williamdelsea/Protogen-Flex-Glove/.repo/images/paperSchematic.jpg

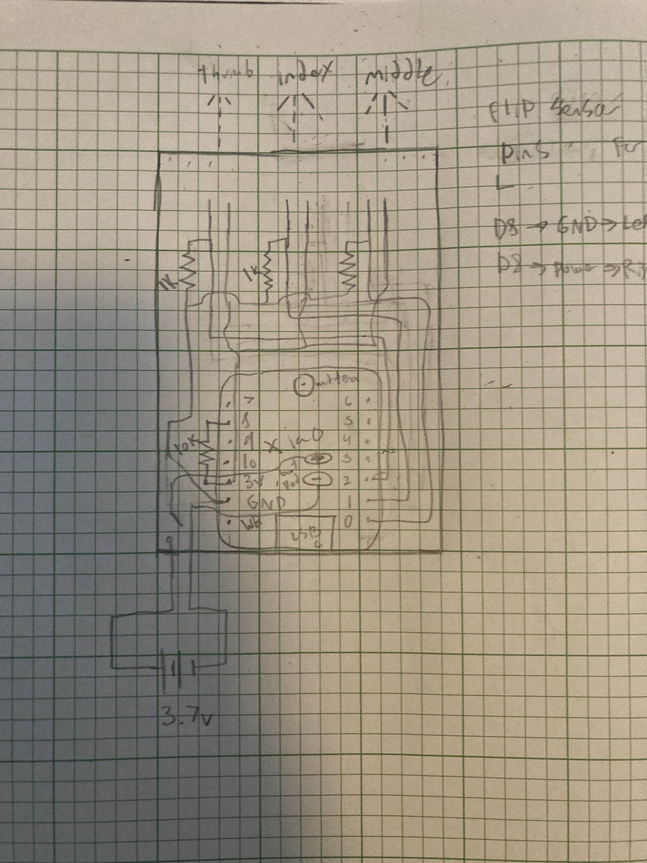
.repo/images/paperSchematic.jpg
