williamdelsea/Protogen-Flex-Glove/.repo/images/serverOff.jpg

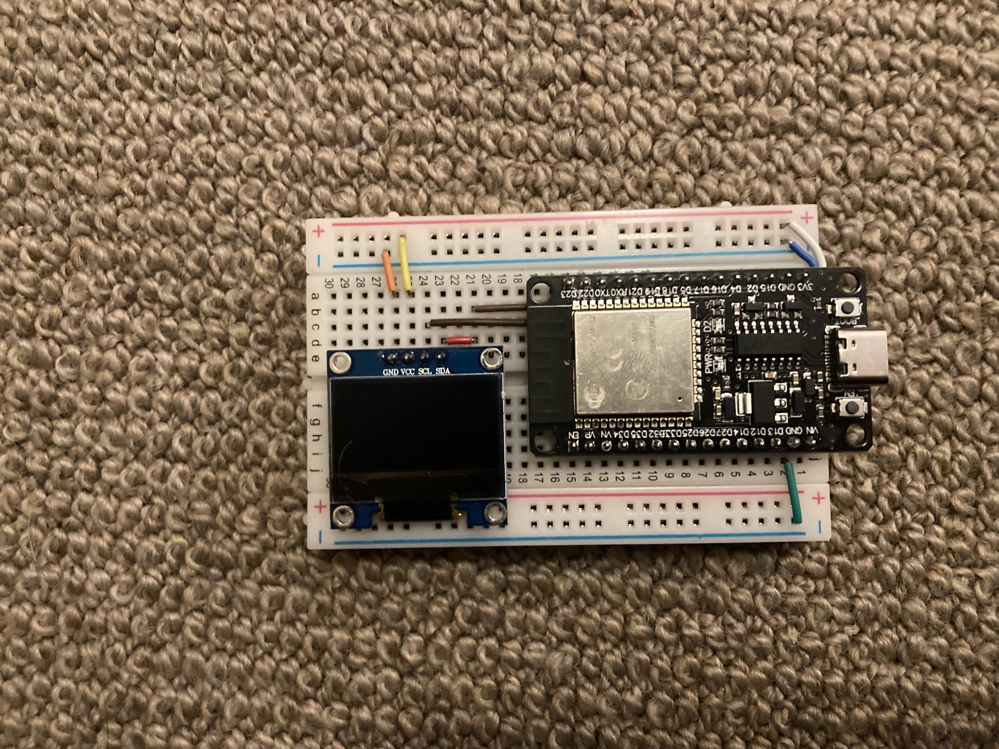
.repo/images/serverOff.jpg
