williamdelsea/Protogen-Flex-Glove/(commit log)

2024-05-24 glove client contains sensor pins, ability to differentiate between left and right client, and sending 8bit data of flex status
    [ClientGlove.ino]
2024-05-25 working LED prototype
2024-05-28 two client functionality with LED example
2024-05-28 pin connection to Xiao
2024-05-28 able to check battery voltage for client
2024-05-29 displayes battery percent on oled
2024-05-30 reverted changes to pin connections
2024-05-30 supports checking battery, need to find more about ADC1/2
2024-05-31 battery data is sent over bluetooth
2024-06-02 displays connected devices on oled
2024-06-07 working address stuff for clients and reverted to analog input
    [ClientGlove.ino, Server.ino]
2024-06-16 updated info about flex sensors
2024-06-16 client support for flex sensors
    [ClientGlove.ino]
2024-09-09 updated schematic image
